SHC-ASTRA/ASTRA_End-Effector_Electronics/End-Effector_Electronics/End-Effector_Electronics.kicad_pcb

## KiCad design End-Effector_Electronics/End-Effector_Electronics.kicad_pcb (2022-03-17)

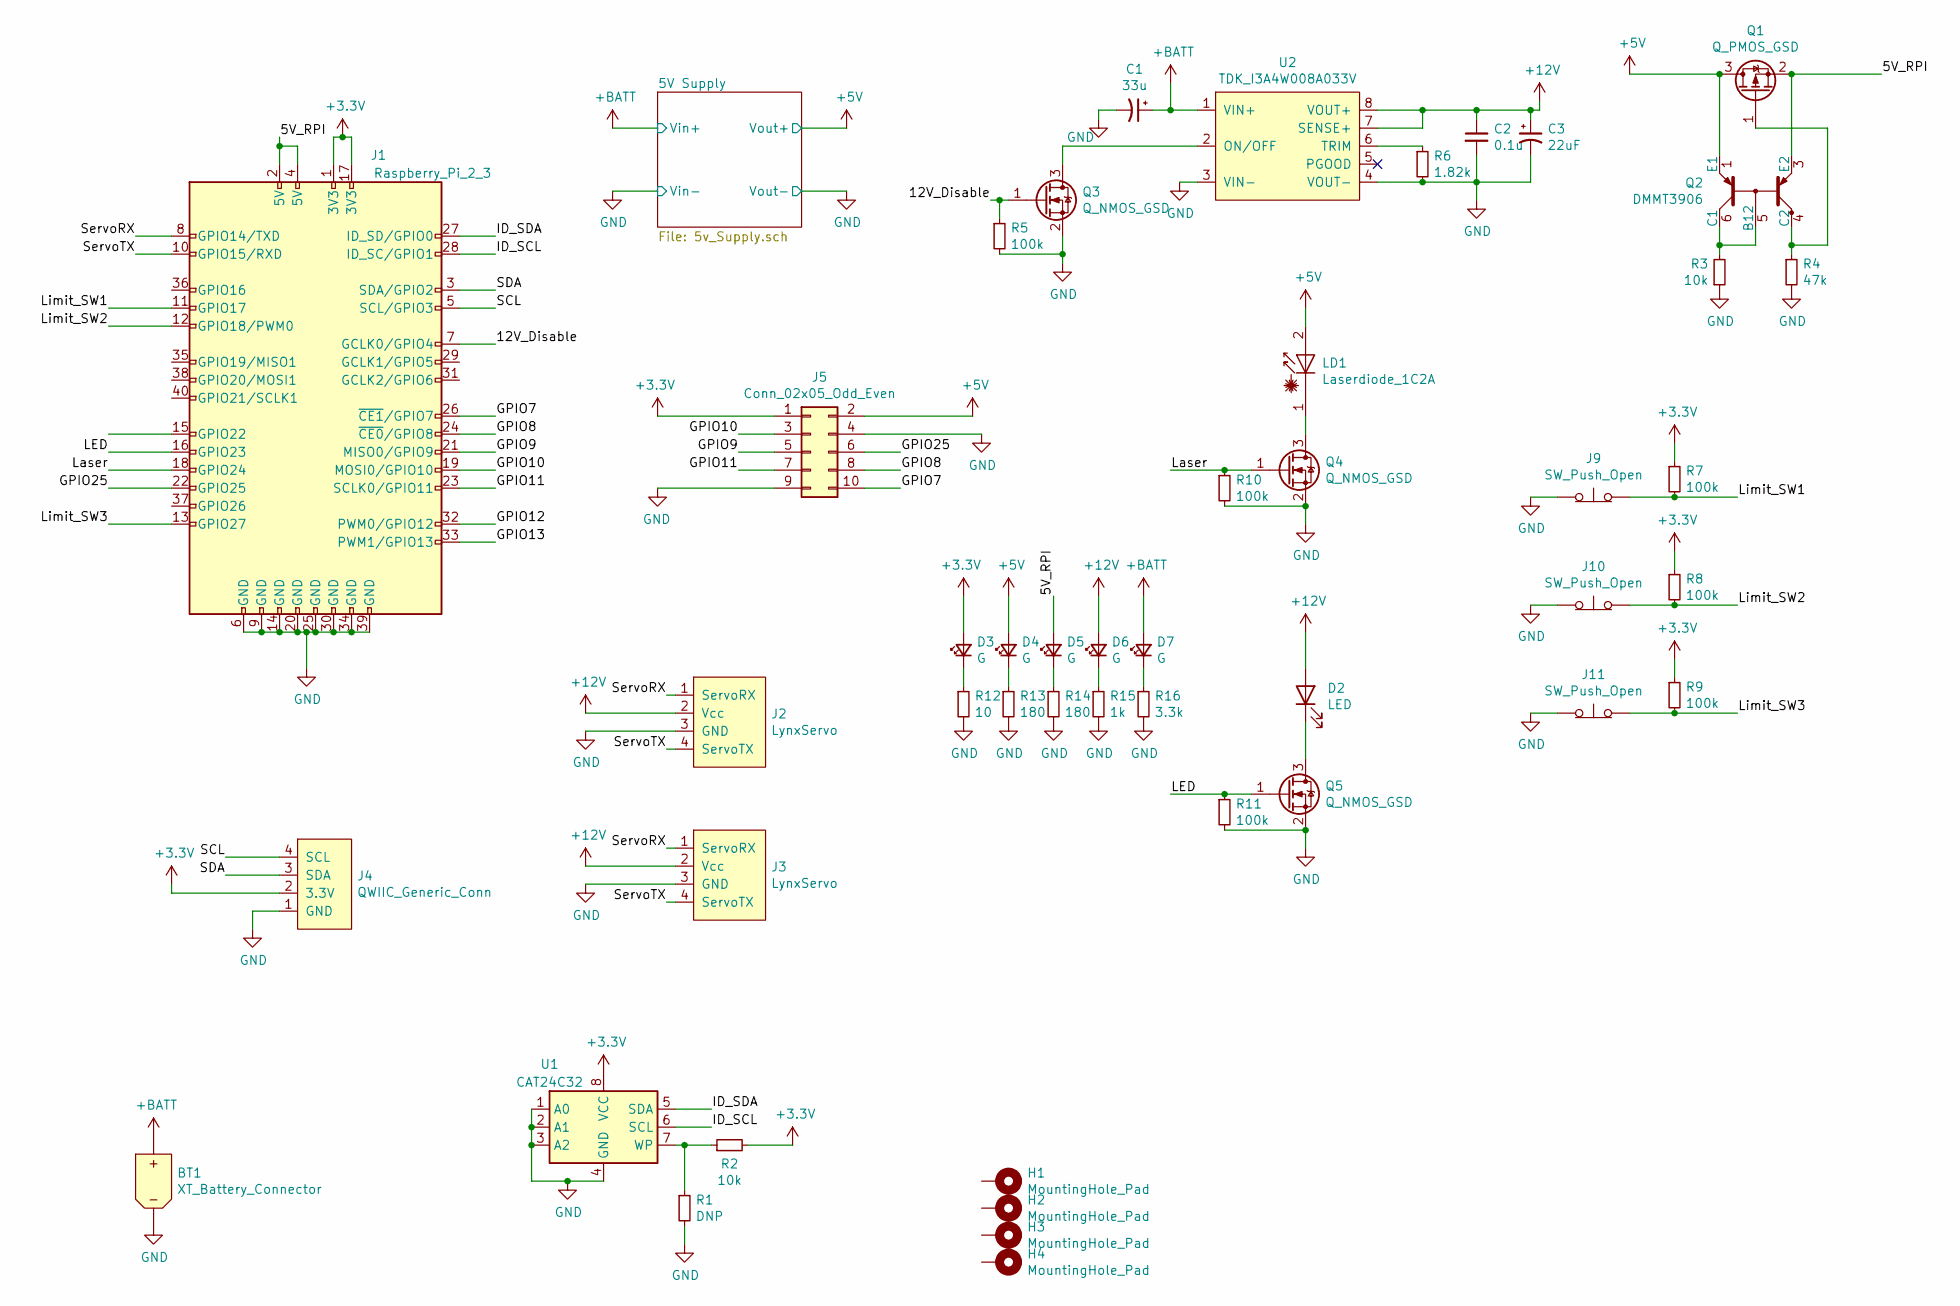
[picture p1: schematic End-Effector_Electronics.sch]

Parts:
BT1: XT_Battery_Connector; AMASS_XT30U-M_1x02_P5.0mm_Vertical; Digikey Part Num n/a
C1: 33u; CP_Elec_6.3x5.4; Digikey Part Num PCE4244CT-ND
C2: 0.1u; C_0603_1608Metric; Digikey Part Num n/a
C3: 22uF; CP_Elec_6.3x5.4; Digikey Part Num 493-9805-1-ND
D2: LED; JST_PH_B2B-PH-K_1x02_P2.00mm_Vertical; Digikey Part Num 1647-1021-1-ND
D3, D4, D5, D6, D7: G; LED_0603_1608Metric_Pad1.05x0.95mm_HandSolder; Digikey Part Num 732-4971-1-ND
H1, H2, H3, H4: MountingHole_Pad; MountingHole_2.7mm_M2.5_Pad; Digikey Part Num n/a
J1: Raspberry_Pi_2_3; PinSocket_2x20_P2.54mm_Vertical_SMD
J2, J3: LynxServo; Molex_SPOX_5268-04A_1x04_P2.50mm_Horizontal; Digikey Part Num 23-0022057045-ND
J4: QWIIC_Generic_Conn; JST_SH_SM04B-SRSS-TB_1x04-1MP_P1.00mm_Horizontal; Digikey Part Num n/a
J5: Conn_02x05_Odd_Even; PinHeader_2x05_P2.54mm_Vertical_SMD
J9, J10, J11: SW_Push_Open; JST_PH_B2B-PH-K_1x02_P2.00mm_Vertical
LD1: Laserdiode_1C2A; JST_PH_B2B-PH-K_1x02_P2.00mm_Vertical; Digikey Part Num 1528-1391-ND
Q1: Q_PMOS_GSD; SOT-23; Digikey Part Num TSM500P02CXRFGCT-ND
Q2: DMMT3906; SOT-23-6; Digikey Part Num DMMT3906-7-FDICT-ND
Q3, Q4, Q5: Q_NMOS_GSD; SOT-23; Digikey Part Num DMN2041L-7DICT-ND
R1: DNP; R_0603_1608Metric; Digikey Part Num n/a
R2, R3: 10k; R_0603_1608Metric; Digikey Part Num n/a
R4: 47k; R_0603_1608Metric; Digikey Part Num 311-47.0KHRCT-ND
R5, R7, R8, R9, R10, R11: 100k; R_0603_1608Metric; Digikey Part Num 311-100KHRCT-ND
R6: 1.82k; R_0603_1608Metric; Digikey Part Num RMCF0603FT1K82CT-ND
R12: 10; R_0603_1608Metric; Digikey Part Num 311-10.0HRCT-ND
R13, R14: 180; R_0603_1608Metric; Digikey Part Num 311-180HRCT-ND
R15: 1k; R_0603_1608Metric; Digikey Part Num 311-1.00KHRCT-ND
R16: 3.3k; R_0603_1608Metric; Digikey Part Num 311-3.30KHRCT-ND
U1: CAT24C32; TSSOP-8_4.4x3mm_P0.65mm; Digikey Part Num CAT24C32YI-GT3OSCT-ND
U2: TDK_I3A4W008A033V; Power_Supply_32nd_Brick; Digikey Part Num I3A4W008A033V-001-R

Connections:
+3V3: D3.2 (A), J1.1 (3V3), J1.17 (3V3), J4.2 (3.3V), J5.1, R2.2, R7.1, R8.1, R9.1, U1.8 (VCC)
+5V: D4.2 (A), J5.2, LD1.2 (A), Q1.3 (D), Q2.1 (E1); also elsewhere on the board
+12V: C2.1, C3.1, D2.2 (A), D6.2 (A), J2.2 (Vcc), J3.2 (Vcc), U2.7 (SENSE+), U2.8 (VOUT+)
+BATT: BT1.2 (Pos), C1.1, D7.2 (A), U2.1 (VIN+); also elsewhere on the board
/5V_RPI: D5.2 (A), J1.2 (5V), J1.4 (5V), Q1.2 (S), Q2.3 (E2)
/12V_Disable: J1.7 (GCLK0/GPIO4), Q3.1 (G), R5.1
/GPIO7: J1.26 (~CE1~/GPIO7), J5.10
/GPIO8: J1.24 (~CE0~/GPIO8), J5.8
/GPIO9: J1.21 (MISO0/GPIO9), J5.5
/GPIO10: J1.19 (MOSI0/GPIO10), J5.3
/GPIO11: J1.23 (SCLK0/GPIO11), J5.7
/GPIO12: J1.32 (PWM0/GPIO12)
/GPIO13: J1.33 (PWM1/GPIO13)
/GPIO25: J1.22 (GPIO25), J5.6
/ID_SCL: J1.28 (ID_SC/GPIO1), U1.6 (SCL)
/ID_SDA: J1.27 (ID_SD/GPIO0), U1.5 (SDA)
/LED: J1.16 (GPIO23), Q5.1 (G), R11.1
/Laser: J1.18 (GPIO24), Q4.1 (G), R10.1
/Limit_SW1: J1.11 (GPIO17), J9.2 (B), R7.2
/Limit_SW2: J1.12 (GPIO18/PWM0), J10.2 (B), R8.2
/Limit_SW3: J1.13 (GPIO27), J11.2 (B), R9.2
/SCL: J1.5 (SCL/GPIO3), J4.4 (SCL)
/SDA: J1.3 (SDA/GPIO2), J4.3 (SDA)
/ServoRX: J1.8 (GPIO14/TXD), J2.1 (ServoRX), J3.1 (ServoRX)
/ServoTX: J1.10 (GPIO15/RXD), J2.4 (ServoTX), J3.4 (ServoTX)
GND: BT1.1 (Neg), C1.2, C2.2, C3.2, J1.6 (GND), J1.9 (GND), J1.14 (GND), J1.20 (GND), J1.25 (GND), J1.30 (GND), J1.34 (GND), J1.39 (GND), J2.3 (GND), J3.3 (GND), J4.1 (GND), J5.4, J5.9, J9.1 (A), J10.1 (A), J11.1 (A), Q3.2 (S), Q4.2 (S), Q5.2 (S), R1.2, R3.1, R4.2, R5.2, R6.2, R10.2, R11.2, R12.2, R13.2, R14.2, R15.2, R16.2, U1.1 (A0), U1.2 (A1), U1.3 (A2), U1.4 (GND), U2.3 (VIN-), U2.4 (VOUT-); also elsewhere on the board
unnamed: D2.1 (K), Q5.3 (D)
unnamed: D3.1 (K), R12.1
unnamed: D4.1 (K), R13.1
unnamed: D5.1 (K), R14.1
unnamed: D6.1 (K), R15.1
unnamed: D7.1 (K), R16.1
unnamed: LD1.1 (K), Q4.3 (D)
unnamed: Q1.1 (G), Q2.4 (C2), R4.1
unnamed: Q2.5 (B12), Q2.6 (C1), R3.2
unnamed: Q3.3 (D), U2.2 (ON/OFF)
unnamed: R1.1, R2.1, U1.7 (WP)
unnamed: R6.1, U2.6 (TRIM)

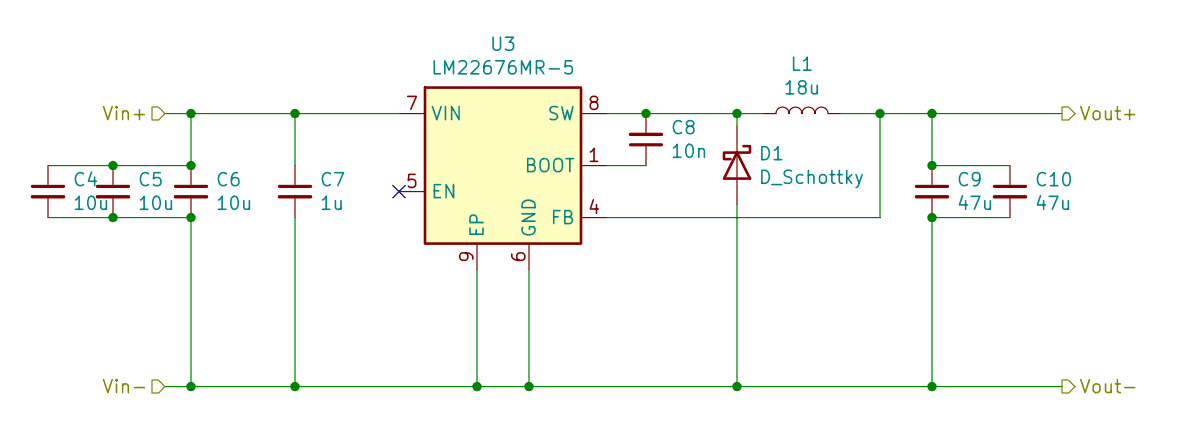
[picture p2: schematic 5v_Supply.sch]

Parts:
C4, C5, C6: 10u; C_1210_3225Metric; Digikey Part Num 445-181658-1-ND
C7: 1u; C_0805_2012Metric; Digikey Part Num 490-10667-1-ND
C8: 10n; C_0603_1608Metric; Digikey Part Num 311-1085-1-ND
C9, C10: 47u; C_1210_3225Metric; Digikey Part Num 732-7382-1-ND
D1: D_Schottky; D_PowerDI-5; Digikey Part Num PDS560DICT-ND
L1: 18u; L_Wuerth_HCI-1050; Digikey Part Num 732-4180-1-ND
U3: LM22676MR-5; TI_SO-PowerPAD-8; Digikey Part Num LM22676MR-5.0/NOPB-ND

Connections:
+5V: C9.1, C10.1, L1.2, U3.4 (FB); also elsewhere on the board
+BATT: C4.1, C5.1, C6.1, C7.1, U3.7 (VIN); also elsewhere on the board
GND: C4.2, C5.2, C6.2, C7.2, C9.2, C10.2, D1.2 (A), U3.6 (GND), U3.9 (EP); also elsewhere on the board
unnamed: C8.1, U3.1 (BOOT)
unnamed: C8.2, D1.1 (K), L1.1, U3.8 (SW)

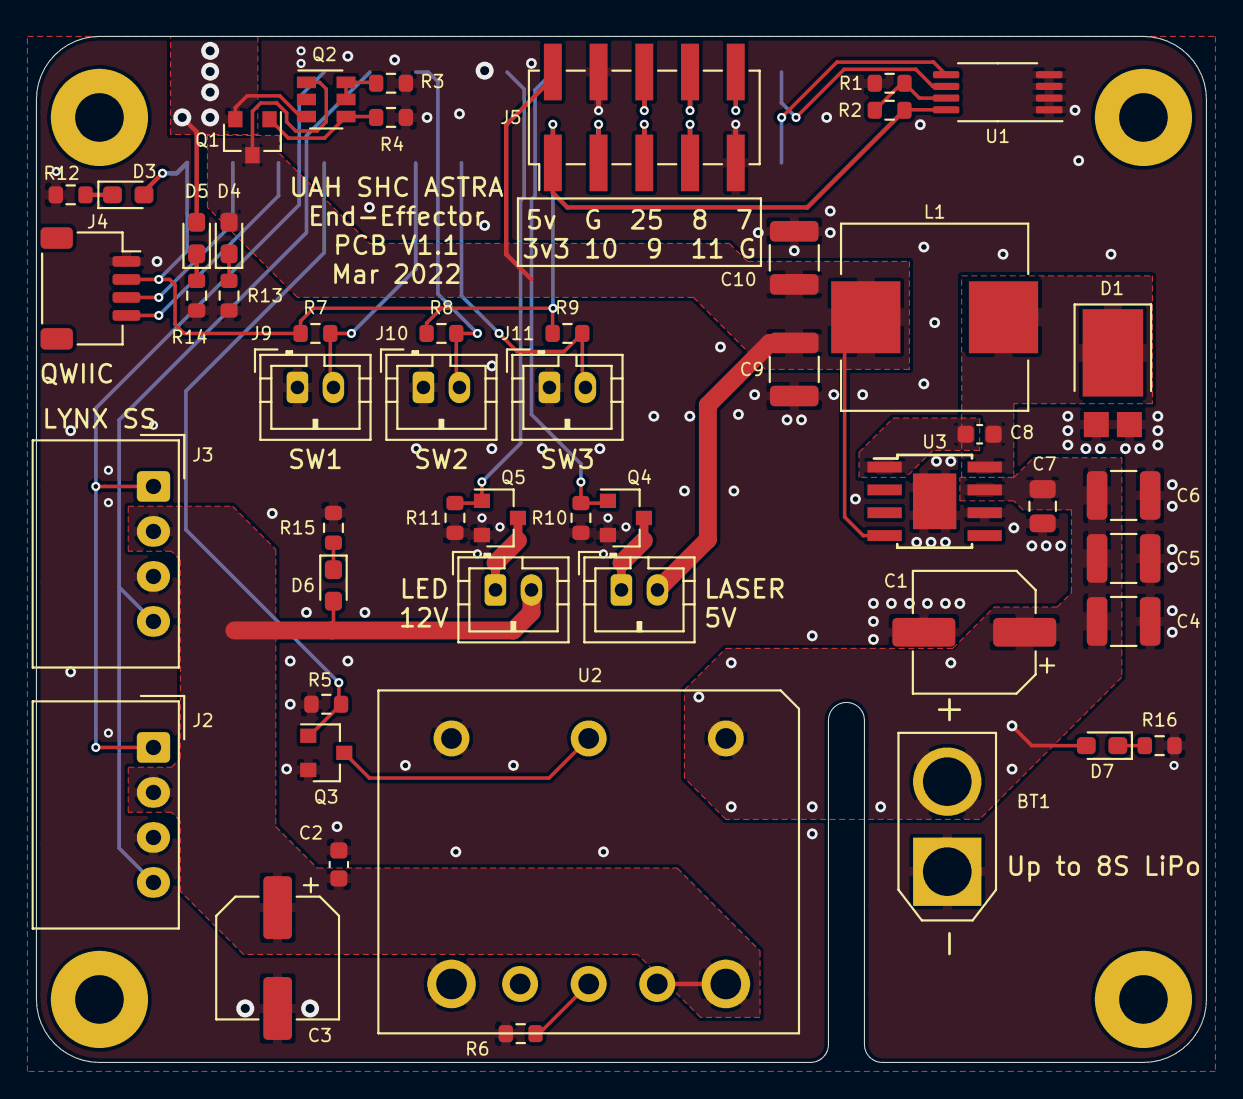
[picture p3: board End-Effector_Electronics.kicad_pcb from above]

Board: 2 copper layers, 65.0 x 57.0 mm, 56 parts (1 on the bottom side), 38 nets.
