SHC-ASTRA/ASTRA_End-Effector_Electronics/(commit log)

2021-10-23 Added KiCAD Files
    [End-Effector_Electronics.kicad_pcb, End-Effector_Electronics.sch]
2021-10-30 Added a few components
    [End-Effector_Electronics.sch]
2021-10-30 Added libraries
    libraries. Replaced BNO055
    [End-Effector_Electronics.sch]
2021-10-30 added sheet for 5v supply
    [5v_Supply.sch, End-Effector_Electronics.sch]
2021-10-30 5V supply added
    [5v_Supply.sch]
2021-10-30 12v supply
    and bno
    [5v_Supply.sch, End-Effector_Electronics.sch]
2021-10-30 Fixed broken thingy
    [5v_Supply.sch, End-Effector_Electronics.sch]
2021-10-30 Added some stuff
    very description
    [End-Effector_Electronics.sch]
2021-11-06 Forgot to commit latest changes
    [End-Effector_Electronics.sch]
2021-11-13 Started associating components
    [5v_Supply.sch, End-Effector_Electronics.sch]
2021-11-19 Worked on finding components
    [5v_Supply.sch, End-Effector_Electronics.sch]
2021-11-19 More component part selection
    [5v_Supply.sch, End-Effector_Electronics.sch]
2021-11-20 finished associating part nums and footprints
    [End-Effector_Electronics.sch]
2021-11-21 Finished layout and routing of initial components
    [End-Effector_Electronics.kicad_pcb, End-Effector_Electronics.sch]
2021-11-21 added things and cleaned up silkscreen
    [End-Effector_Electronics.kicad_pcb, End-Effector_Electronics.sch]
2021-11-21 Swapped a few components
    [End-Effector_Electronics.kicad_pcb, End-Effector_Electronics.sch]
2021-11-21 Fixed errors
    [End-Effector_Electronics.kicad_pcb, End-Effector_Electronics.sch]
2021-12-16 I changed something I guess?
    [End-Effector_Electronics.kicad_pcb]
2022-03-14 Started post SAR fixes
    [End-Effector_Electronics.sch]
2022-03-15 indicator LEDs
    [End-Effector_Electronics.kicad_pcb, End-Effector_Electronics.sch]
2022-03-17 Indicator LEDs in PCB
    [End-Effector_Electronics.kicad_pcb, End-Effector_Electronics.sch]
